jeremyrode/pico_elancontrol/README.md

# pico_elancontrol
Work in progress.  Current rewriting my [Elan S6 Controller Code](https://github.com/jeremyrode/elancontrol/)  to use a Raspberry Pi Pico to do the bit-banging.
