jeremyrode/pico_elancontrol/PCB/README.md

PCB had to have some minor rework, switch source and drain on PMOS!

Problem fixed
