jeremyrode/pico_elancontrol/PCB/elan_interface.kicad_pcb

## KiCad design PCB/elan_interface.kicad_pcb (2025-03-19)

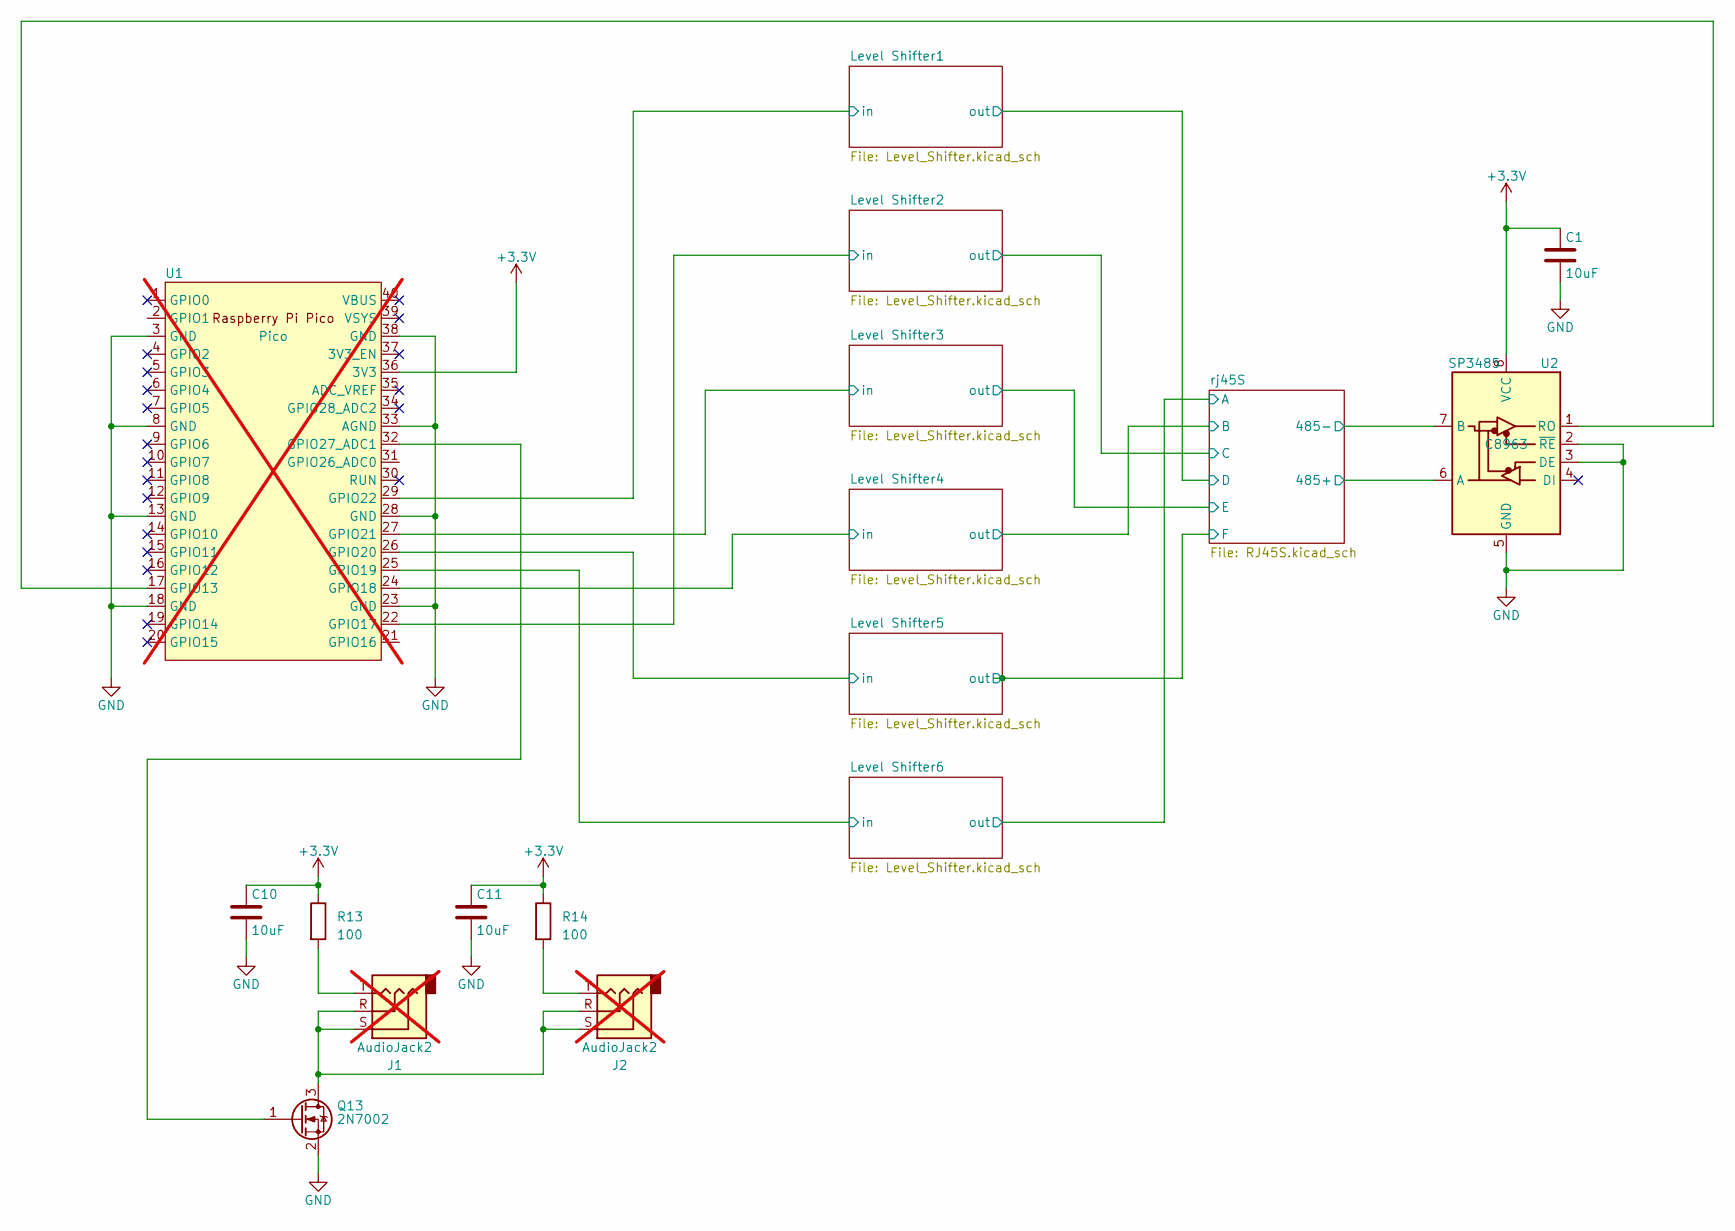
[picture p1: schematic elan_interface.kicad_sch]

Parts:
C1, C10, C11: 10uF; C_0805_2012Metric_Pad1.18x1.45mm_HandSolder
J1, J2: AudioJack2; Jack_3.5mm_CUI_SJ1-3533NG_Horizontal_CircularHoles; not fitted
Q13: 2N7002; SOT-23
R13, R14: 100; R_0805_2012Metric_Pad1.20x1.40mm_HandSolder
U1: Pico; RaspberryPi_Pico_Common_THT; not fitted
U2: SP3485; NSOIC-8

Connections:
+3.3V: C1.1, C10.1, C11.1, R13.1, R14.1, U1.36 (3V3), U2.8 (VCC)
/Level Shifter1/in: U1.29 (GPIO22); also elsewhere on the board
/Level Shifter2/in: U1.22 (GPIO17); also elsewhere on the board
/Level Shifter3/in: U1.27 (GPIO21); also elsewhere on the board
/Level Shifter4/in: U1.24 (GPIO18); also elsewhere on the board
/Level Shifter5/in: U1.26 (GPIO20); also elsewhere on the board
/Level Shifter6/in: U1.25 (GPIO19); also elsewhere on the board
/rj45S/485+: U2.6 (A); also elsewhere on the board
/rj45S/485-: U2.7 (B); also elsewhere on the board
GND: C1.2, C10.2, C11.2, Q13.2 (S), U1.3 (GND), U1.8 (GND), U1.13 (GND), U1.18 (GND), U1.23 (GND), U1.28 (GND), U1.33 (AGND), U1.38 (GND), U2.2 (~RE), U2.3 (DE), U2.5 (GND); also elsewhere on the board
unnamed: J1.T, R13.2
unnamed: J2.T, R14.2
unnamed: J1.R, J1.S, J2.R, J2.S, Q13.3 (D)
unnamed: Q13.1 (G), U1.32 (GPIO27_ADC1)
unnamed: U1.17 (GPIO13), U2.1 (RO)

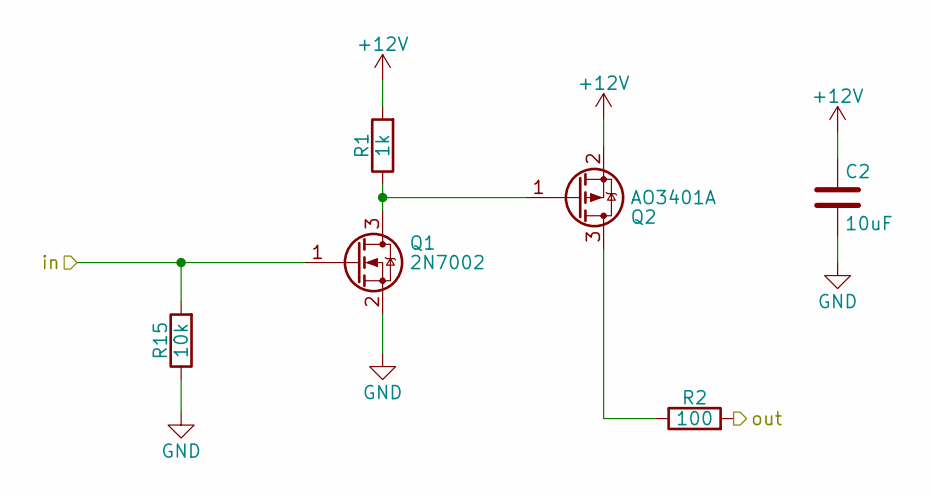
[picture p2: schematic Level_Shifter.kicad_sch]

Parts:
C2: 10uF; C_0805_2012Metric_Pad1.18x1.45mm_HandSolder
Q1: 2N7002; SOT-23
Q2: AO3401A; SOT-23
R1: 1k; R_0805_2012Metric_Pad1.20x1.40mm_HandSolder
R2: 100; R_0805_2012Metric_Pad1.20x1.40mm_HandSolder
R15: 10k; R_0805_2012Metric_Pad1.20x1.40mm_HandSolder

Connections:
+12V: C2.1, Q2.2 (S), R1.2; also elsewhere on the board
/Level Shifter1/in: Q1.1 (G), R15.2; also elsewhere on the board
/Level Shifter1/out: R2.2; also elsewhere on the board
GND: C2.2, Q1.2 (S), R15.1; also elsewhere on the board
unnamed: Q1.3 (D), Q2.1 (G), R1.1
unnamed: Q2.3 (D), R2.1

Parts of its further copies:
C5, C6, C7, C8, C9: 10uF; C_0805_2012Metric_Pad1.18x1.45mm_HandSolder
Q3, Q5, Q7, Q9, Q11: 2N7002; SOT-23
Q4, Q6, Q8, Q10, Q12: AO3401A; SOT-23
R3, R5, R7, R9, R11: 1k; R_0805_2012Metric_Pad1.20x1.40mm_HandSolder
R4, R6, R8, R10, R12: 100; R_0805_2012Metric_Pad1.20x1.40mm_HandSolder
R16, R17, R18, R19, R20: 10k; R_0805_2012Metric_Pad1.20x1.40mm_HandSolder

Connections of its further copies:
+12V: C5.1, C6.1, C7.1, C8.1, C9.1, Q4.2 (S), Q6.2 (S), Q8.2 (S), Q10.2 (S), Q12.2 (S), R3.2, R5.2, R7.2, R9.2, R11.2; also elsewhere on the board
/Level Shifter2/in: Q3.1 (G), R16.2; also elsewhere on the board
/Level Shifter2/out: R4.2; also elsewhere on the board
/Level Shifter3/in: Q5.1 (G), R17.2; also elsewhere on the board
/Level Shifter3/out: R6.2; also elsewhere on the board
/Level Shifter4/in: Q7.1 (G), R18.2; also elsewhere on the board
/Level Shifter4/out: R8.2; also elsewhere on the board
/Level Shifter5/in: Q9.1 (G), R19.2; also elsewhere on the board
/Level Shifter5/out: R10.2; also elsewhere on the board
/Level Shifter6/in: Q11.1 (G), R20.2; also elsewhere on the board
/Level Shifter6/out: R12.2; also elsewhere on the board
GND: C5.2, C6.2, C7.2, C8.2, C9.2, Q3.2 (S), Q5.2 (S), Q7.2 (S), Q9.2 (S), Q11.2 (S), R16.1, R17.1, R18.1, R19.1, R20.1; also elsewhere on the board
unnamed: Q3.3 (D), Q4.1 (G), R3.1
unnamed: Q4.3 (D), R4.1
unnamed: Q5.3 (D), Q6.1 (G), R5.1
unnamed: Q6.3 (D), R6.1
unnamed: Q7.3 (D), Q8.1 (G), R7.1
unnamed: Q8.3 (D), R8.1
unnamed: Q10.3 (D), R10.1
unnamed: Q9.3 (D), Q10.1 (G), R9.1
unnamed: Q11.3 (D), Q12.1 (G), R11.1
unnamed: Q12.3 (D), R12.1

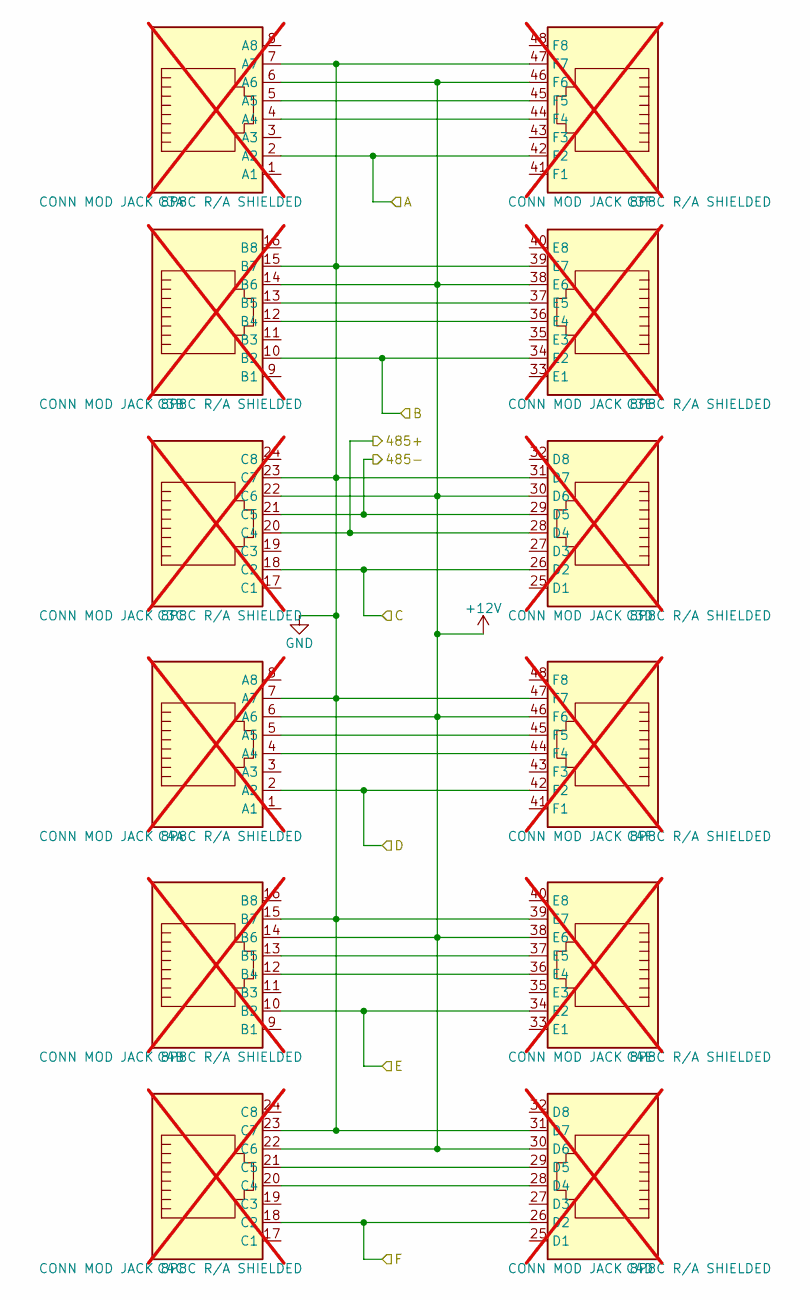
[picture p3: schematic RJ45S.kicad_sch]

Parts:
C3, C4: CONN MOD JACK 8P8C R/A SHIELDED; 5569256-1; not fitted

Connections:
+12V: C3.6 (A6), C3.14 (B6), C3.22 (C6), C3.30 (D6), C3.38 (E6), C3.46 (F6), C4.6 (A6), C4.14 (B6), C4.22 (C6), C4.30 (D6), C4.38 (E6), C4.46 (F6); also elsewhere on the board
/Level Shifter1/out: C4.2 (A2), C4.42 (F2); also elsewhere on the board
/Level Shifter2/out: C3.18 (C2), C3.26 (D2); also elsewhere on the board
/Level Shifter3/out: C4.10 (B2), C4.34 (E2); also elsewhere on the board
/Level Shifter4/out: C3.10 (B2), C3.34 (E2); also elsewhere on the board
/Level Shifter5/out: C4.18 (C2), C4.26 (D2); also elsewhere on the board
/Level Shifter6/out: C3.2 (A2), C3.42 (F2); also elsewhere on the board
/rj45S/485+: C3.20 (C4), C3.28 (D4); also elsewhere on the board
/rj45S/485-: C3.21 (C5), C3.29 (D5); also elsewhere on the board
GND: C3.7 (A7), C3.15 (B7), C3.23 (C7), C3.31 (D7), C3.39 (E7), C3.47 (F7), C4.7 (A7), C4.15 (B7), C4.23 (C7), C4.31 (D7), C4.39 (E7), C4.47 (F7); also elsewhere on the board
unnamed: C3.4 (A4), C3.44 (F4)
unnamed: C3.5 (A5), C3.45 (F5)
unnamed: C3.12 (B4), C3.36 (E4)
unnamed: C3.13 (B5), C3.37 (E5)
unnamed: C4.4 (A4), C4.44 (F4)
unnamed: C4.5 (A5), C4.45 (F5)
unnamed: C4.12 (B4), C4.36 (E4)
unnamed: C4.13 (B5), C4.37 (E5)
unnamed: C4.20 (C4), C4.28 (D4)
unnamed: C4.21 (C5), C4.29 (D5)

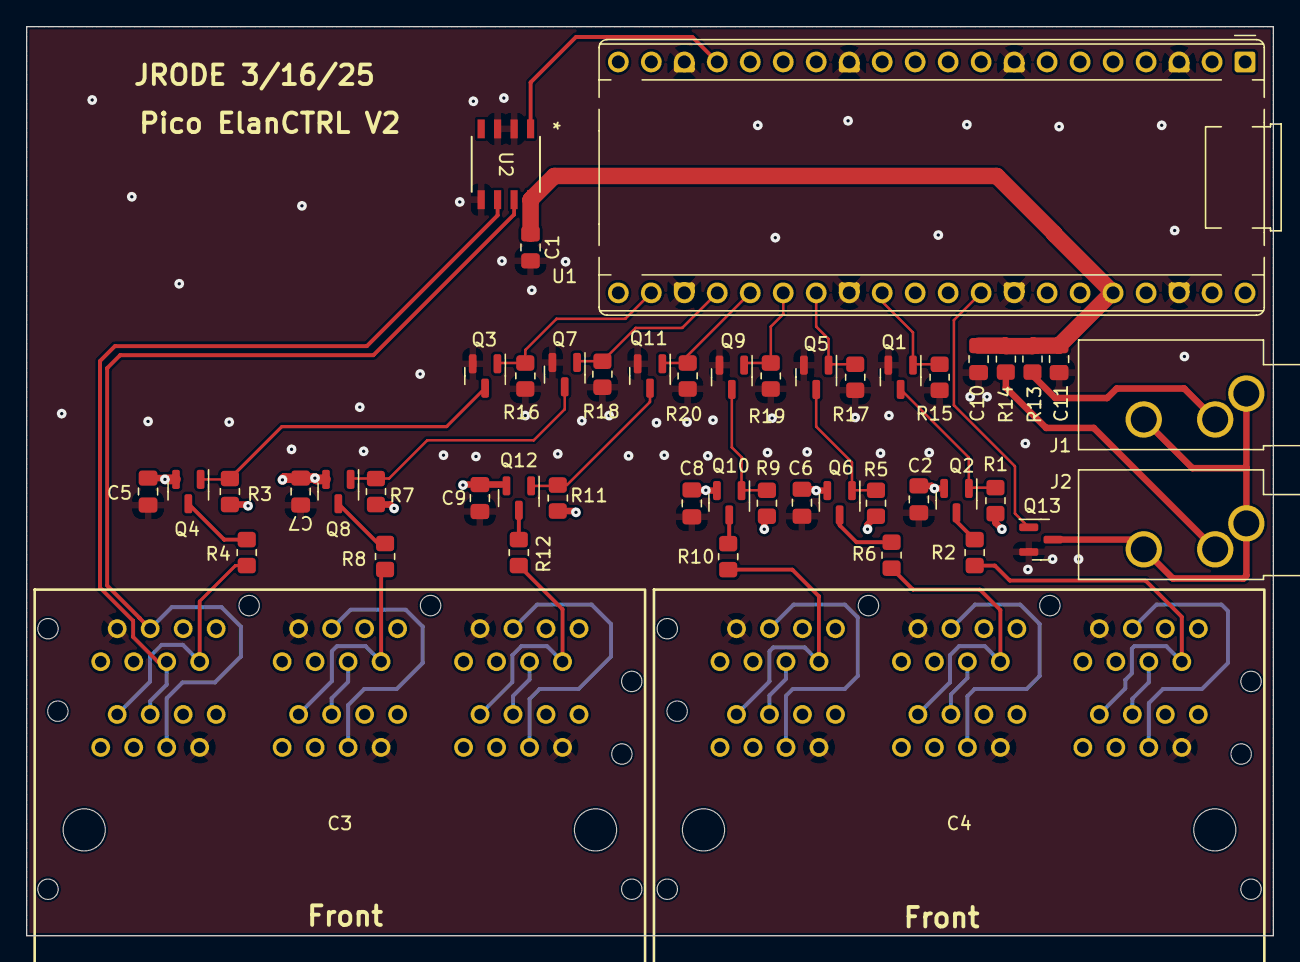
[picture p4: board elan_interface.kicad_pcb from above]

Board: 2 copper layers, 96.0 x 70.0 mm, 48 parts (0 on the bottom side), 44 nets.
