jeremyrode/pico_elancontrol/(commit log)

2023-10-11 Add PCB
    [Level_Shifter.kicad_sch, RJ45S.kicad_sch, test_jer.csv, test_jer.kicad_pcb, test_jer.kicad_sch]
2023-11-18 Read test working with error passing
    [server.js, status_testing.js]
2023-11-29 Fixed keepalive and status not sending on update
    [elancontrol.c, server.js]
2024-11-09 Fixed switched source and drain on PMOS
    On 12V common source amp for level shifter in subcircuit
    [Level_Shifter.kicad_sch, RJ45S.kicad_sch, test_jer.kicad_pcb, test_jer.kicad_sch]
2025-03-16 Version 2 of PCB
    [Level_Shifter.kicad_sch, RJ45S.kicad_sch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]
